Danzaywer/SturdyBunnyProject/images/im1.jpeg

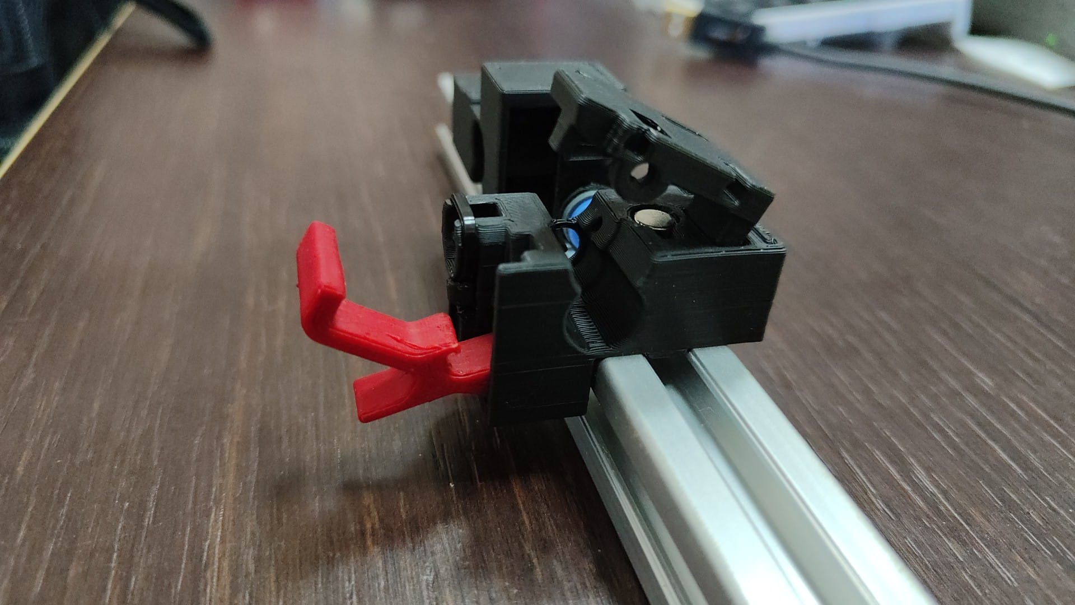
images/im1.jpeg
