Danzaywer/SturdyBunnyProject/images/im2.jpeg

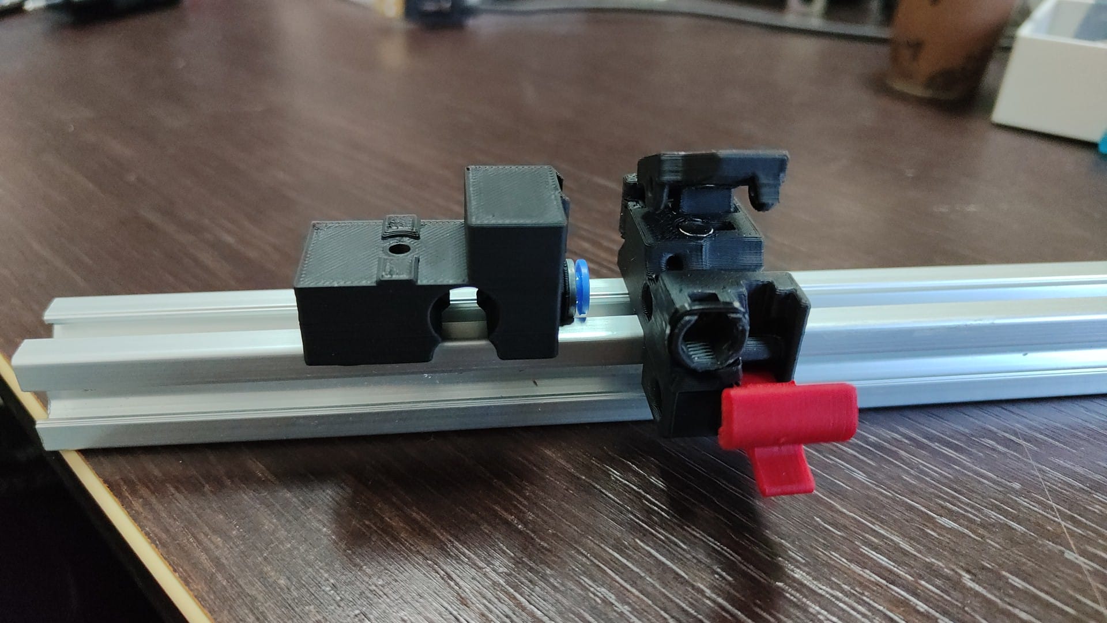
images/im2.jpeg
