Danzaywer/SturdyBunnyProject/Carrot_Feeder/Stls/Filament blocks/filament_block_END_supportfree.stl

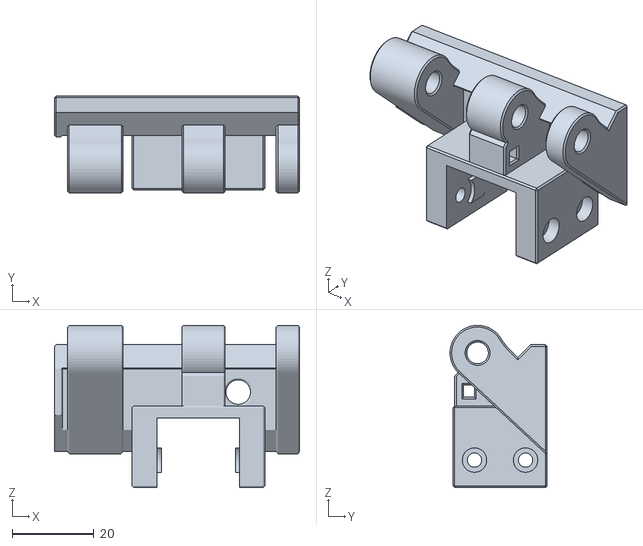
[picture p4: CAD file, 2023-04-11]
Carrot_Feeder/Stls/Filament blocks/filament_block_END_supportfree.stl
60.0 x 23.7 x 39.7
