Danzaywer/SturdyBunnyProject/Carrot_Feeder/Stls/Gear box/BOTTOM_PANEL_supportfree.stl

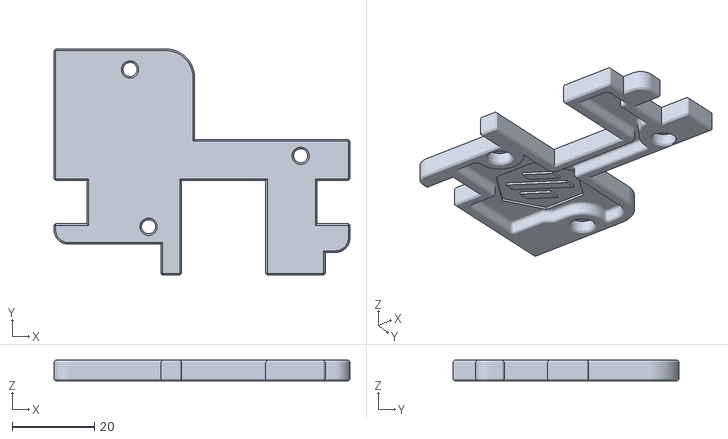
[picture p5: CAD file, 2023-04-11]
Carrot_Feeder/Stls/Gear box/BOTTOM_PANEL_supportfree.stl
72.0 x 55.0 x 5.00
