Danzaywer/SturdyBunnyProject/Carrot_Feeder/Stls/Filament blocks/filament_block_supportfree.stl

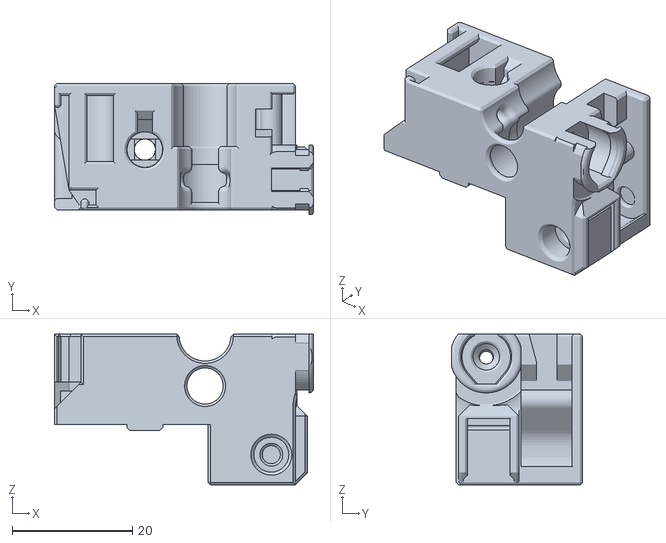
[picture p6: CAD file, 2023-04-11]
Carrot_Feeder/Stls/Filament blocks/filament_block_supportfree.stl
43.0 x 21.8 x 25.0
