Danzaywer/SturdyBunnyProject/Carrot_Feeder/Stls/Gear box/gearbox_front_supportfree.stl

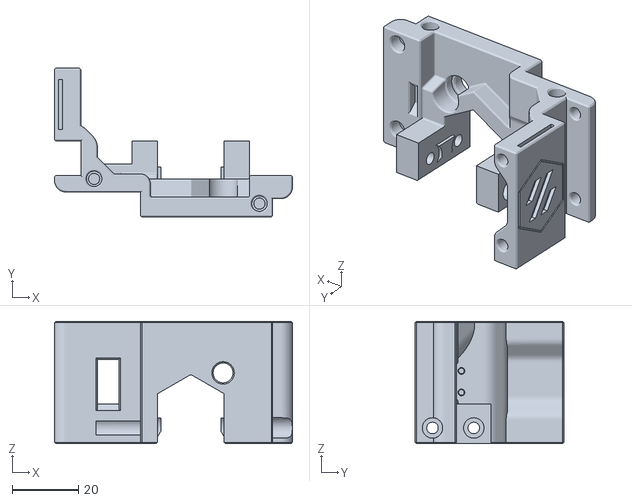
[picture p7: CAD file, 2023-04-11]
Carrot_Feeder/Stls/Gear box/gearbox_front_supportfree.stl
72.0 x 45.0 x 37.0
