Danzaywer/SturdyBunnyProject/Carrot_Feeder/Stls/Filament blocks/filament_block_BEARING_supportfree.stl

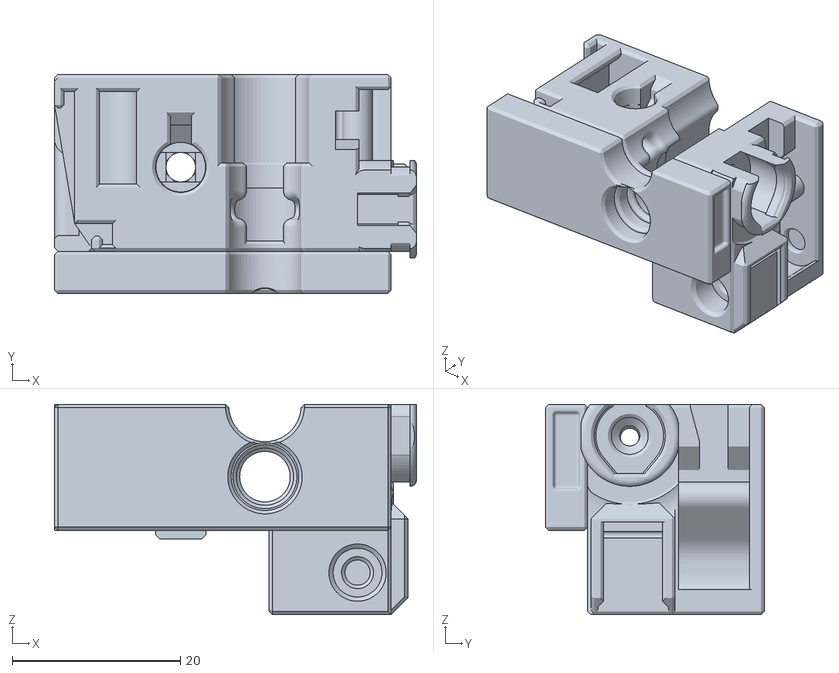
[picture p8: CAD file, 2023-04-11]
Carrot_Feeder/Stls/Filament blocks/filament_block_BEARING_supportfree.stl
43.0 x 26.0 x 25.0
