Danzaywer/SturdyBunnyProject/Carrot_Feeder/Stls/Filament blocks/TOP_hat_supportfree.stl

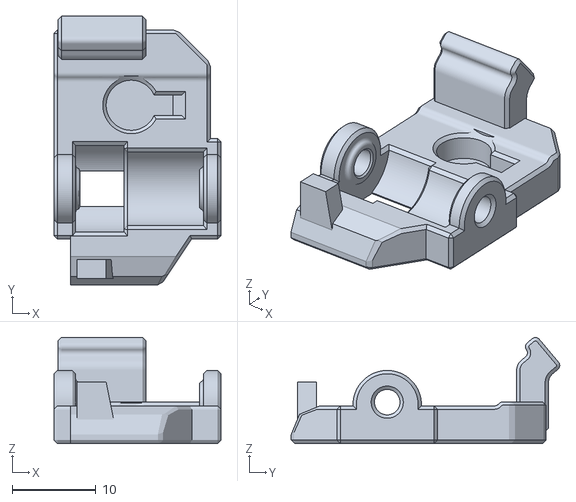
[picture p9: CAD file, 2023-04-11]
Carrot_Feeder/Stls/Filament blocks/TOP_hat_supportfree.stl
20.0 x 32.2 x 12.7
