Danzaywer/SturdyBunnyProject/(commit log)

2023-04-11 UPLOAD SUPPORTFREE STL
    upload filament_block_supportfree, filament_block_BEARING_supportfree,TOP_hat_supportfree
    [TOP_hat_supportfree.stl, filament_block_BEARING_supportfree.stl, filament_block_supportfree.stl]
2023-04-11 UPLOAD GEARBOX STL
    upload gearbox_front_supportfree, BOTTOM_PANEL_supportfree
    [BOTTOM_PANEL_supportfree.stl, gearbox_front_supportfree.stl]
2023-04-11 UPLOAD STL
    upload filament_block_END_supportfree
    [filament_block_END_supportfree.stl]
